psten/pd-buddy-sink/(commit log)

2017-02-16 Added PD-Buddy v0.1 PCB
    Tested to probably not blow anything up if assembled properly!
    [microcontroller.sch, output.sch, pd-buddy.csv, pd-buddy.kicad_pcb, pd-buddy.sch, pd_phy.sch, usb_type-c.sch, voltage_regulator.sch]
2017-02-17 Corrected MOSFET connections
    I had the source and drain reversed—whoops. After fixing it with an
    X-Acto knife and some point-to-point wiring, I've updated the schematic
    and PCB files accordingly.
    THIS ALSO MARKS THE BEGINNING OF DEVELOPMENT OF THE NEXT BOARD REVISION.
    [microcontroller.sch, output.sch, pd-buddy.kicad_pcb, pd-buddy.sch, pd_phy.sch, usb_type-c.sch, voltage_regulator.sch]
2017-02-22 Corrected BJT connections
    Boy, I'm good at messing up transistors! This time it was just the pin
    numbers for the collector and emitter reversed, because I didn't copy
    the symbol from the datasheet but rather assumed another SMT 2222 would
    have the same pinout. Interestingly, it actually was able to control
    the MOSFET at VBUS = 5 V and at VBUS = 9 V, but at VBUS = 15 V the
    reversed transistor couldn't pull the MOSFET gate down enough.
    [output.sch, pd-buddy.kicad_pcb]
2017-03-03 Added a jumper to make SW1 optional
    0 Ω resistors are cheap, and switches are expensive. It would be nice
    to be able to save the price of a switch, since it's not really
    necessary anyway. I can program these by SWD, after all.
    I added a 0 Ω resistor, R11, to pull the BOOT pin to ground in lieu of
    having SW1 installed to do the same job.
    [microcontroller.sch, output.sch, pd-buddy.kicad_pcb, pd_phy.sch, usb_type-c.sch]
2017-03-06 Corrected type of INT_N sheet pin
    It was bidirectional on the Microcontroller sheet, which is wrong. Now
    it's input, like it should be.
    [microcontroller.sch, pd-buddy.sch]
2017-03-13 Moved board edge 0.5 mm closer to P1
    The USB Type-C connector was a bit far from the board edge, so I moved
    the edge 0.5 mm closer to it. This allows enclosure walls to be thicker
    and whatnot. I also moved the screw holes back to keep them the same
    distance from the board edge, and moved D4 and R10 to keep their text
    unobscured.
    [pd-buddy.kicad_pcb]
2017-03-19 Rename board to PD Buddy Sink
    Google likes the name better this way. Plus, it provides clear naming
    for possible future PD Buddy products.
    [microcontroller.sch, output.sch, pd-buddy.kicad_pcb, pd-buddy.sch, pd_phy.sch, usb_type-c.sch, voltage_regulator.sch]
2017-03-31 Reversed output connector, widened traces
    Now there's a filled zone connecting the MOSFET output to the connector,
    and the + side of the output is close to the MOSFET. Both connector
    leads have no thermal relief, for minimum resistance.
    [output.sch, pd-buddy.kicad_pcb]
2017-03-31 Thicker high-current traces
    All the power traces immediately around the MOSFET are now zones.
    Huzzah! The power traces at the USB connector are slightly wider now
    too. And to top it off, the ground connection to the power output
    connector now has a separate zone to remove the thermal relief instead
    of wide traces.
    [pd-buddy.kicad_pcb]
2017-04-01 Updated footprints
    KiCAD made a lot of small changes to a lot of footprints, so I updated
    them all. About the biggest difference I saw was the pads for the SWD
    header are closer together.
    [pd-buddy.kicad_pcb]
2017-04-01 Changed names of user-facing components
    The LED does a lot more than indicate that power negotiation failed, so
    its name has been changed from NOPWR to Status. The boot mode switch
    doesn't need to be yelling, so its name is changed from BOOT to Boot.
    [microcontroller.sch, pd-buddy.kicad_pcb]
2017-04-01 Changed long VBUS trace to zone
    The long VBUS trace connecting the USB connector to the MOSFET was a bit
    marginal in terms of width, and plenty of room was available for it.
    Therefore, I decided to change it into a filled zone, which is at least
    5 mm wide for most of its length. The resistance will be much lower,
    and all the vias stitching it to the other VBUS zone under the MOSFET
    will help carry heat away as well.
    [pd-buddy.kicad_pcb]
2017-04-01 Added F.Fab outline to USB Type-C connector
    There was previously no way of seeing where the business end of the USB
    connector was. To solve this, I added a crude outline of the connector
    on the F.Fab layer.
    [pd-buddy.kicad_pcb]
2017-04-03 SMD flyback diode, 0.5 mm shorter PCB
    Since it really seems like a good idea to include the flyback diode by
    default, I decided to change it to a surface mount device. After that,
    I noticed that it would be easy to shave another 0.5 mm off the end of
    the PCB, so I did.
    [output.sch, pd-buddy.kicad_pcb]
2017-04-03 Moved index mark on MLP-14 footprint
    It was so close to the pad that it wasn't on the soldermask, causing the
    fab to remove it almost entirely. This should fix that problem.
    [pd-buddy.kicad_pcb]
2017-04-06 Changed boot pin circuit
    The switch is optional, no components need to be removed when it's
    installed, and there's no zero-ohm jumper. This circuit has been tested
    on a modified v0.1 board, and it works fine.
    [microcontroller.sch, pd-buddy.kicad_pcb]
2017-04-06 No paste on P2 or SW1
    They won't be installed by default, so there shouldn't be solder paste
    applied to their pads. To that end, I copied the footprints to the
    pd-buddy library and removed the paste from all their pads.
    [microcontroller.sch, pd-buddy.kicad_pcb]
2017-04-06 Added pasteless footprints
    Apparently `git commit -a` doesn't add untracked files. Oops.
2017-04-07 Moved traces under SWD connector
    As it was, had the silkscreen been shifted a conceivable amount, it
    could have exposed portions of traces to nearby pads, opening the door
    for accidental shorts during soldering. Fixed by keeping the traces
    farther away from neighboring pads.
    [pd-buddy.kicad_pcb]
2017-04-08 Added a note in the README about board specs
2017-04-08 Revised high-current traces
    Now the board should be much happier carrying 5 A, possibly even with
    1 oz copper. I'd still prefer to get it made with 2 oz copper as a
    matter of principle, but IPC-2152 calculations make it look like I'd
    probably be okay with 1 oz.
    [pd-buddy.kicad_pcb]
2017-04-09 Corrected position of MK2
    I don't know how that mounting hole got mispositioned, but it was.
    [pd-buddy.kicad_pcb]
2017-04-14 Moved SW1 slider over board
    The slider for the Boot switch is no longer overhanging the board edge.
    This is nice for designing enclosures, as now nothing overhangs the long
    sides of the board.
    [pd-buddy.kicad_pcb]
2017-04-14 Moved J1 entirely on board
    The edge of the power output connector no longer overhangs the edge.
    Now only the USB connector does, and it really should.
    [pd-buddy.kicad_pcb]
2017-04-15 Enlarged traces to U1 thermals
    The traces to the thermal vias for U1 shouldn't have been as small as
    they were. Not that U1 gets particularly hot, but it would just be
    nicer to use thick traces to extend to the thermal vias.
    [pd-buddy.kicad_pcb]
2017-04-16 Named BOOT net
    [microcontroller.sch, pd-buddy.kicad_pcb]
2017-04-19 Post-release version bump
    [microcontroller.sch, output.sch, pd-buddy.kicad_pcb, pd-buddy.sch, pd_phy.sch, usb_type-c.sch, voltage_regulator.sch]
2017-04-19 Rename project files to pd-buddy-sink
    That's the name they should have, since the board hasn't been called PD
    Buddy since v0.1.
    [pd-buddy-sink.csv, pd-buddy-sink.kicad_pcb, pd-buddy-sink.sch]
2017-04-19 Added Amphenol 12401610E4#2A
    It's a USB Type-C connector just like the one used in v0.1 and v0.2, but
    with only SMT pins (except the fixing pins, of course). They're
    slightly cheaper and probably nicer for automated assembly, but
    impossible to hand-solder. That's okay though: where we're going, we
    don't need hand-solderability.
    [microcontroller.sch, output.sch, pd-buddy-sink.sch, pd_phy.sch, usb_type-c.sch, voltage_regulator.sch]
2017-04-19 Changed USB connector to SMD version
    There's now quite a bit of stuff located under the USB connector. A lot
    of manufacturers mark that area as a keep-out zone, but luckily,
    Amphenol is not one of them.
    [pd-buddy-sink.kicad_pcb, usb_type-c.sch]
2017-04-20 Changed R9 to 100 kΩ
    As it was, it wasted around 85 mW whenever the output was turned on at
    20 V. That's a silly waste of power. A 100 kΩ pullup works just fine,
    so I changed it. Now there's only 4 mW wasted, so I'm happy.
    [output.sch, pd-buddy-sink.kicad_pcb]
2017-04-24 4-layer board with smaller components
    This is a major change! Almost all the components have changed to
    smaller versions, with 0603 and 0402 passives and a QFN microcontroller.
    The board now has four layers, with internal layers used for VBUS and
    GND. The board now measures a mere 25×30 mm! The SWD header and Boot
    switch footprints have been moved to the bottom to help with this
    shrinkage. Two test points were added to the bottom as well to make it
    possible to power the board without using the USB connector. The
    mounting holes are now slightly smaller (better sized for M3), and only
    17 mm apart instead of the old 18 mm.
    To sum up, everything is smaller and that's almost entirely a goo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
    [microcontroller.sch, output.sch, pd-buddy-sink.kicad_pcb, pd-buddy-sink.sch, pd_phy.sch, usb_type-c.sch, voltage_regulator.sch]
2017-04-25 Updated README for v0.3 development
    2 oz copper is no longer needed, and neither is a thin board.
2017-04-26 Added fiducials to board top
    [pd-buddy-sink.kicad_pcb]
2017-04-26 Moved C11 and C12 references
    [pd-buddy-sink.kicad_pcb]
2017-04-26 Added fiducial refs, moved some other refs around
    [pd-buddy-sink.kicad_pcb]
2017-04-27 0.15 mm annular rings
    Now the board is within spec for MacroFab. Also, the power traces at
    the USB connector are thicker, so should be able to carry high currents
    more easily.
    [pd-buddy-sink.kicad_pcb]
2017-04-27 Changed R10 to 220 Ω
    It'll make the LED a bit brighter, and it's a more common value.
    [microcontroller.sch, pd-buddy-sink.kicad_pcb]
2017-05-06 Added _KI_LIB_GIT library path
    Set the _KI_LIB_GIT path to point to a local copy of the kicad-library
    Git repository. Then this project will pick up the Git libraries
    instead of the system ones.
2017-05-06 Use FUSB302BMPX from standard kicad-library
    Now that the appropriate pull requests have been merged, I can use the
    standard part rather than the one I created in this repository.
    Speaking of which, this commit removes FUSB302B and MLP-14 from this
    repository.
    [pd-buddy-sink.kicad_pcb, pd_phy.sch]
2017-05-11 Use new USB Type-C schematic symbol
    The footprints haven't been merged yet, but the symbol has. Therefore,
    I updated the footprint in the pd-buddy library to match the new symbol
    (changed shield pin number to S1) and changed the schematic to have the
    new connector symbol. The board looks the same except that a couple
    references changed.
    [microcontroller.sch, pd-buddy-sink.kicad_pcb, usb_type-c.sch]
2017-05-12 SOD-323F footprint for D2 and D3
    KiCad has the right footprint now, so I don't have to substitute an
    SOD-323 footprint. The 3D model looks less inaccurate I suppose, but
    still not right for the particular diodes I'm using.
    [pd-buddy-sink.kicad_pcb, pd_phy.sch]
2017-05-12 Change part for D2 and D3
    Now they're MM3Z5V6T1G, an SOD-323 5.6 V 300 mW Zener diode. Similar to
    the old part, but easier to solder and cheaper. One of those two points
    matters.
    [pd-buddy-sink.kicad_pcb, pd_phy.sch]
2017-05-13 Remove fiducial refs and trace between NC pads
    [pd-buddy-sink.kicad_pcb]
2017-05-13 Moved PD Buddy Sink KiCad project to new directory
    In preparation for adding a second board (the programming jig) to this
    repository, I've moved the PD Buddy Sink files to their own directory.
    [microcontroller.sch, output.sch, pd-buddy-sink.csv, pd-buddy-sink.kicad_pcb, pd-buddy-sink.sch, pd_phy.sch, usb_type-c.sch, voltage_regulator.sch]
2017-05-15 Added programming jig PCB
    It's a small board, just a bit bigger than a PD Buddy Sink v0.1.
    Nothing unexpected, just pogo pins and connectors and two resistors
    because it has a USB Type-C receptacle for power input. The plastic
    piece screws on and the whole thing should work just great, making the
    SWD header unnecessary on the v0.3 PCBs. It's even compatible with the
    boot switch, and with a 2-pin 0.1 in. male header on the bottom as an
    output connector.
    [programming-jig.kicad_pcb, programming-jig.sch]
2017-05-28 Update footprints
    The SOT-89 footprint changed its name slightly in the KiCad library,
    so the voltage regulator has been updated accordingly. It has a nice
    new 3D model too. It's not weird and blue anymore. I like it.
    The SOD-123 was also updated to have a 3D model. The board now only
    lacks models for the footprints I made myself. Heh.
    [pd-buddy-sink.kicad_pcb, voltage_regulator.sch]
2017-05-28 Removed USB connector symbols
    The footprints have been updated to be used with the mainline KiCad
    schematic symbol, so the symbols in the pd-buddy library were useless.
    They were also overall a lot worse, and furthermore, they were unused.
    This commit removes the old USB connector schematic symbols from the
    pd-buddy library.
2017-05-28 Use VBUS symbol from power library
    With the VBUS symbol merged into the KiCad library, I no longer need to
    use my own. This commit changes the schematic to use the standard VBUS
    symbol rather than a custom one.
    [microcontroller.sch, output.sch, pd-buddy-sink.sch, pd_phy.sch, usb_type-c.sch, voltage_regulator.sch]
2017-05-28 Use power symbols in programming jig schematic
    The power lines had been drawn as regular wires with net labels. That's
    not great, so I changed them to use power symbols. It's better now!
    [programming-jig.kicad_pcb, programming-jig.sch]
2017-05-30 Use USB connector from Connectors_USB.pretty
    My USB Type-C connectors were merged into the KiCad
    Connectors_USB.pretty footprint library, so I can use it from the normal
    library now.
    [microcontroller.sch, output.sch, pd-buddy-sink.kicad_pcb, pd-buddy-sink.sch, pd_phy.sch, usb_type-c.sch, voltage_regulator.sch]
2017-06-09 Added oval drills to Edge.Cuts layer
    MacroFab wants oval drills to be marked on the board edge layer, so
    that's what I'm doing. Hopefully they'll be able to handle oval drills
    better soon, given a recent comment on their blog.
    [pd-buddy-sink.kicad_pcb]
2017-06-09 Shrunk programming jig outline
    By removing clearance around the printed piece, I was able to shrink the
    board to 95.6% of the area it had before. That'll save me a few cents.
    [programming-jig.kicad_pcb]
2017-07-06 Use PTS810 pushbutton switch for SW2
    Assuming I'm going to keep ordering boards from MacroFab, it makes sense
    to use their house parts as much as possible. Therefore, the next
    boards will use a C&K PTS810 as the Setup switch instead of an Alps
    SKQG. In addition to saving money, this change allows room for larger
    "Setup" and "GND" labels.
    [microcontroller.sch, output.sch, pd-buddy-sink.kicad_pcb, pd-buddy-sink.sch, pd_phy.sch, usb_type-c.sch, voltage_regulator.sch]
2017-07-08 Removed copper from between SW1 pins 2 and 3
    In the previous board version, there was a trace (OUT_CTRL) between the
    Boot switch's pins 2 and 3. Since those two pins are the ones that
    need to be shorted to enter DFU mode, it's possible that users wanting
    to upgrade the device's firmware would want to short them with a blob
    of solder rather than buying a switch. While the soldermask *should*
    prevent this solder blob from shorting the OUT_CTRL line high,
    soldermask can be accidentally scraped off, so I don't want to rely on
    it in this case.
    This commit moves the OUT_CTRL trace out from between SW1 pins 2 and 3,
    and adds a keepout zone between those two pins. This should make it
    much safer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
    [pd-buddy-sink.kicad_pcb]
2017-07-08 Moved a few reference designators
    U2 was moved to remove ambiguity. Q1 was moved to ensure it isn't cut
    off by a hole. U1 was moved to stay away from where MacroFab put their
    secret manufacturing code.
    [pd-buddy-sink.kicad_pcb]
2017-07-08 Updated schematic with official AP2204R-3.3 symbol
    Now that my pull request for the AP2204 regulators has been merged, I
    can finally update the PD Buddy Sink schematic to use it.
    [pd-buddy-sink.kicad_pcb, voltage_regulator.sch]
2017-07-08 Changed via dimensions
    Now signal vias are MacroFab's minimum size, and power vias have a
    slightly smaller drill than before to not be slightly pushing
    MacroFab's design rules.
    [pd-buddy-sink.kicad_pcb]
2017-07-09 Changed Q1 to MMBT3904
    It used to be an MMBT2222, now it's an MMBT3904. The new transistor is
    slightly lower-spec'd, but is still more than plenty for this
    application. Also, it's a MacroFab house part, so the boards will be
    even cheaper to manufacture.
    [output.sch, pd-buddy-sink.kicad_pcb]
2017-07-09 Make all schematic sheets US Letter size
    [microcontroller.sch, output.sch, pd_phy.sch, usb_type-c.sch, voltage_regulator.sch]
2017-07-16 Made mounting holes have solid connection to zones
    There's not really any reason for mounting holes to have thermal relief,
    since they don't normally get soldered. Removing the thermal relief may
    make them resist tearing more, too.
    [pd-buddy-sink.kicad_pcb]
2017-07-16 Changed SW1 and P1 footprints
    The components on the bottom, SW1 and P1, were using slightly modified
    footprints from the KiCad library (default, but with no paste on any
    pads) in v0.3. Now they're back to the default footprints, but with
    local paste clearance set to -100% to make sure there's no paste on any
    of their pads.
    [microcontroller.sch, pd-buddy-sink.kicad_pcb]
2017-07-16 Removed unused NOPASTE footprints
2017-07-16 Removed an unused MOSFET symbol
2017-07-18 Changed Q2 and D1
    D1 is now a B140, which is a MacroFab house part. It's actually a bit
    more expensive from distributors than the SS14FL, but the lack of a
    labor charge makes it quite a bit cheaper for PCBA. It's also larger,
    so in order to fit the new part, I moved it between Q2 and J1. This is
    possible because…
    Q2 is now a DMP3017SFG. This is a cheaper, smaller, and less
    over-specified MOSFET which should be fine for the job of controlling
    the PD Buddy Sink's output. It uses a proprietary Diodes Inc. package
    whose footprint I contributed to KiCad's library. Because the new
    MOSFET is so much smaller than the old one, I was able to fit it close
    to the board edge where R9 used to be.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
    [output.sch, pd-buddy-sink.kicad_pcb]
2017-07-18 Added some VBUS vias near Q2
    [pd-buddy-sink.kicad_pcb]
2017-07-18 Improved current carrying capacity
    More vias near Q2, one via removed near J2 to make the VBUS plane have
    more effective width.
    The "PD Buddy Sink v1.0" text has been moved to once again be entirely
    over copper.
    [pd-buddy-sink.kicad_pcb]
2017-07-19 Moved PD Buddy Sink v1.0 text
    [pd-buddy-sink.kicad_pcb]
2017-07-19 Moved some traces to the front layer
    A couple traces went through the board twice for no good reason. Now
    they stay on the front, making fewer holes in the power plane.
    [pd-buddy-sink.kicad_pcb]
2017-07-19 Re-routed a trace
    [pd-buddy-sink.kicad_pcb]
2018-01-29 Use USB connector footprints from KiCad library
    No need to provide our own anymore now that they're all merged upstream.
    [programming-jig.kicad_pcb, programming-jig.sch]
2018-02-26 Update revision to next
    I don't know what version number I want to use for the next board
    revision, but there are changes coming.
    [microcontroller.sch, output.sch, pd-buddy-sink.kicad_pcb, pd-buddy-sink.sch, pd_phy.sch, usb_type-c.sch, voltage_regulator.sch]
2018-02-26 Added test points, replaced SW1 with R11
    More test points will be needed for automated testing, so I've added the
    first two I know of.
    With firmware version 1.2.0+, there's not much reason to install SW1
    anymore. This commit replaces it with R11, an unpopulated resistor
    footprint that does the same thing as bridging the two pins of SW1 used
    to do, just in case an upgrade make the `boot` command stop working.
    [microcontroller.sch, output.sch, pd-buddy-sink.kicad_pcb, pd_phy.sch, usb_type-c.sch, voltage_regulator.sch]
2018-04-23 Update to KiCad 5.0 nightly
    Hooray, new stuff! The STM32 symbol is a reasonable size now! We have
    a sym-lib-table! Everything is great, and I'm excited!
    The board's a bit of a mess though, as the silkscreen needs to be laid
    out nicely. Oh well, details.
    [microcontroller.sch, output.sch, pd-buddy-sink.kicad_pcb, pd-buddy-sink.sch, pd_phy.sch, usb_type-c.sch, voltage_regulator.sch]
2018-04-23 Update footprints
    Hooray for new, better footprints~!
    [microcontroller.sch, pd-buddy-sink.kicad_pcb]
2018-06-06 Update footprint for Q2
    [pd-buddy-sink.kicad_pcb]
2019-02-14 Removed outdated BOM file
    I only committed the BOM file by accident anyway, and it hasn't been
    updated to reflect changes to the board. Removed to avoid confusion.
    [pd-buddy-sink.csv]
